IanL7/connect453/hardware/microcontroller_board/3D/APA102C.STEP

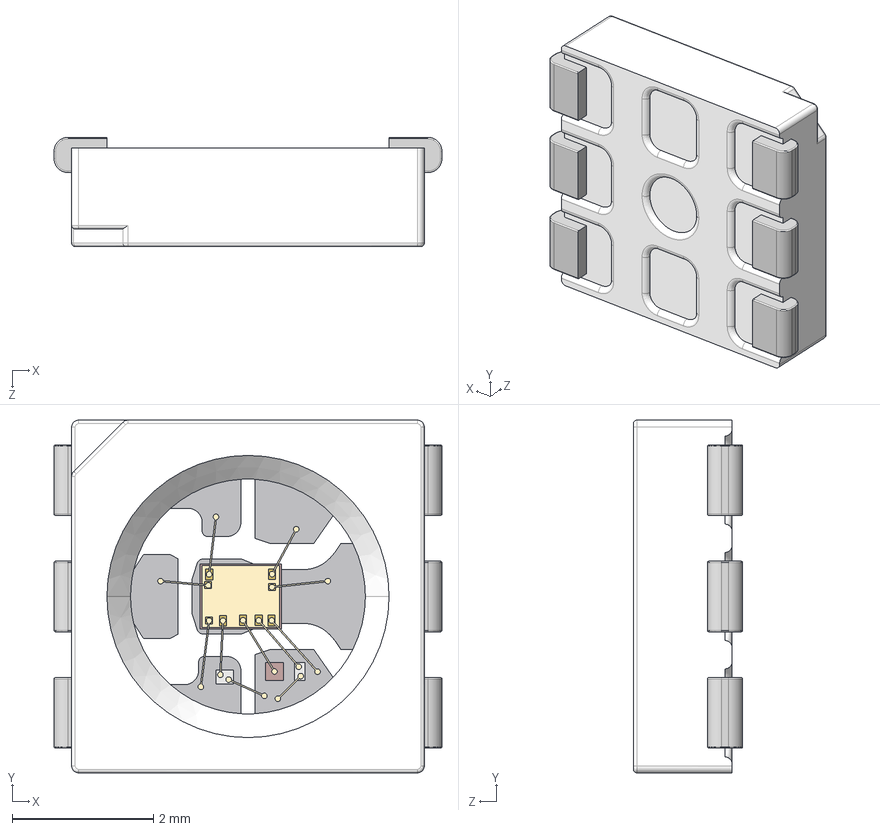
[picture p2: CAD file, 2024-05-06]
hardware/microcontroller_board/3D/APA102C.STEP
5.50 x 5.00 x 1.55 mm
