IanL7/connect453/hardware/microcontroller_board/Parts/TPA6211TDGNRQ1/VSSOP_DGNRQ1_TEX.step

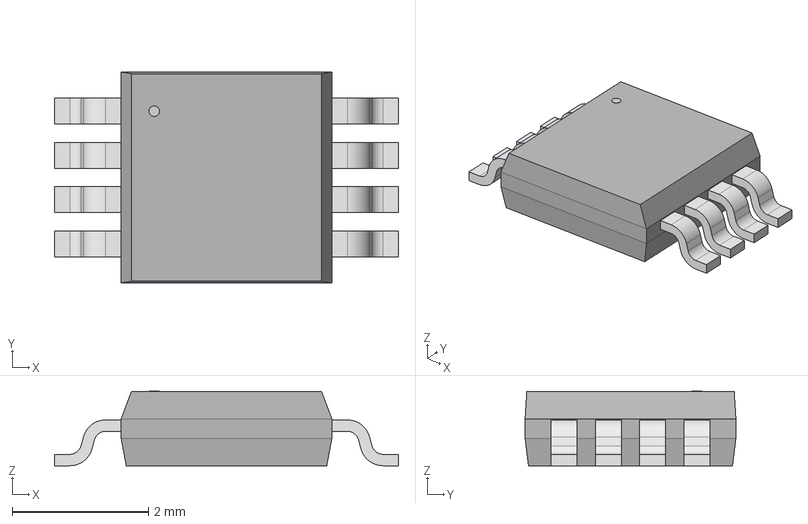
[picture p3: CAD file, 2024-05-06]
hardware/microcontroller_board/Parts/TPA6211TDGNRQ1/VSSOP_DGNRQ1_TEX.step
5.05 x 3.10 x 1.09 mm
