IanL7/connect453/hardware/microcontroller_board/3D/STEP-61301021821-rev1.stp

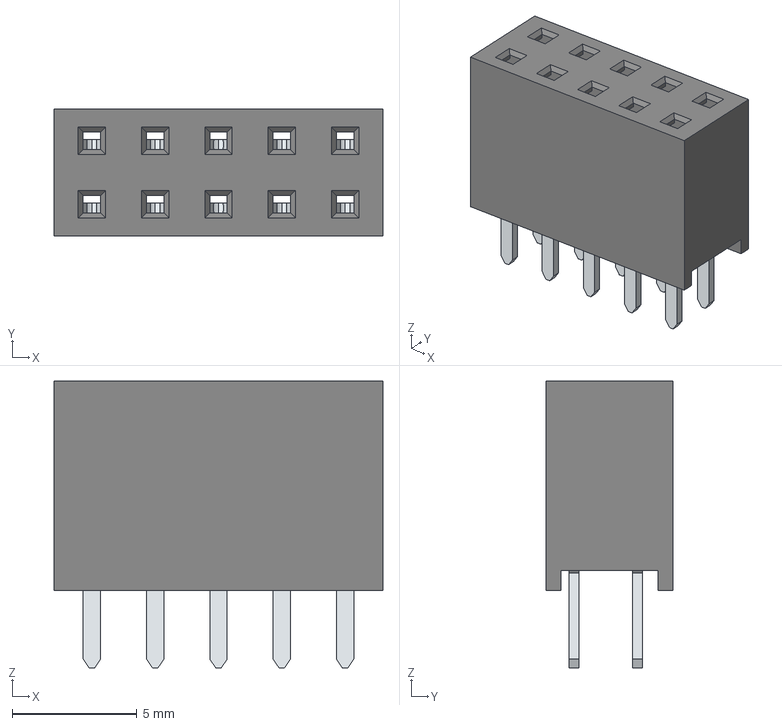
[picture p4: CAD file, 2024-05-06]
hardware/microcontroller_board/3D/STEP-61301021821-rev1.stp
13.2 x 5.08 x 11.5 mm
6130xx21821_PIN x 10
