IanL7/connect453/hardware/microcontroller_board/3D/BU2032SM-HD-GCR2032 Battery Holder.stp

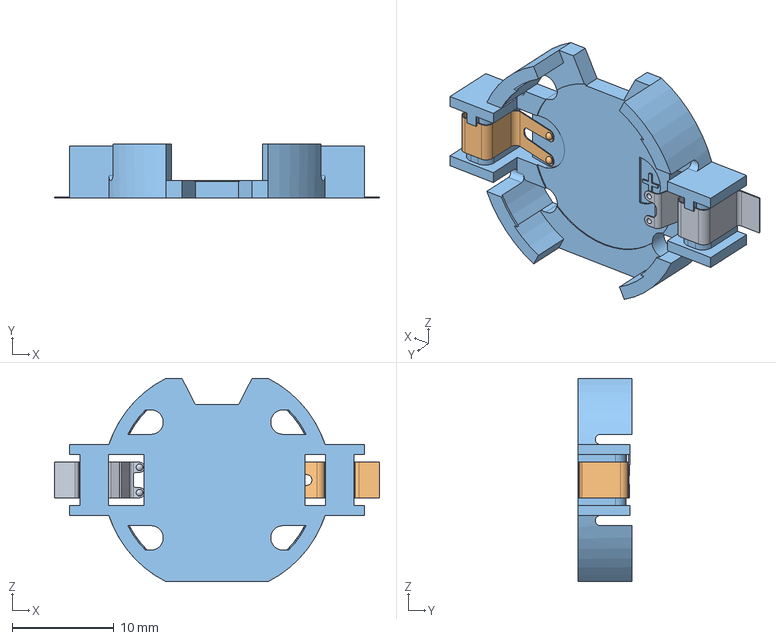
[picture p5: CAD file, 2024-05-06]
hardware/microcontroller_board/3D/BU2032SM-HD-GCR2032 Battery Holder.stp
32.0 x 5.30 x 20.0 mm
