IanL7/connect453/hardware/microcontroller_board/ECE453-MCU.pdf

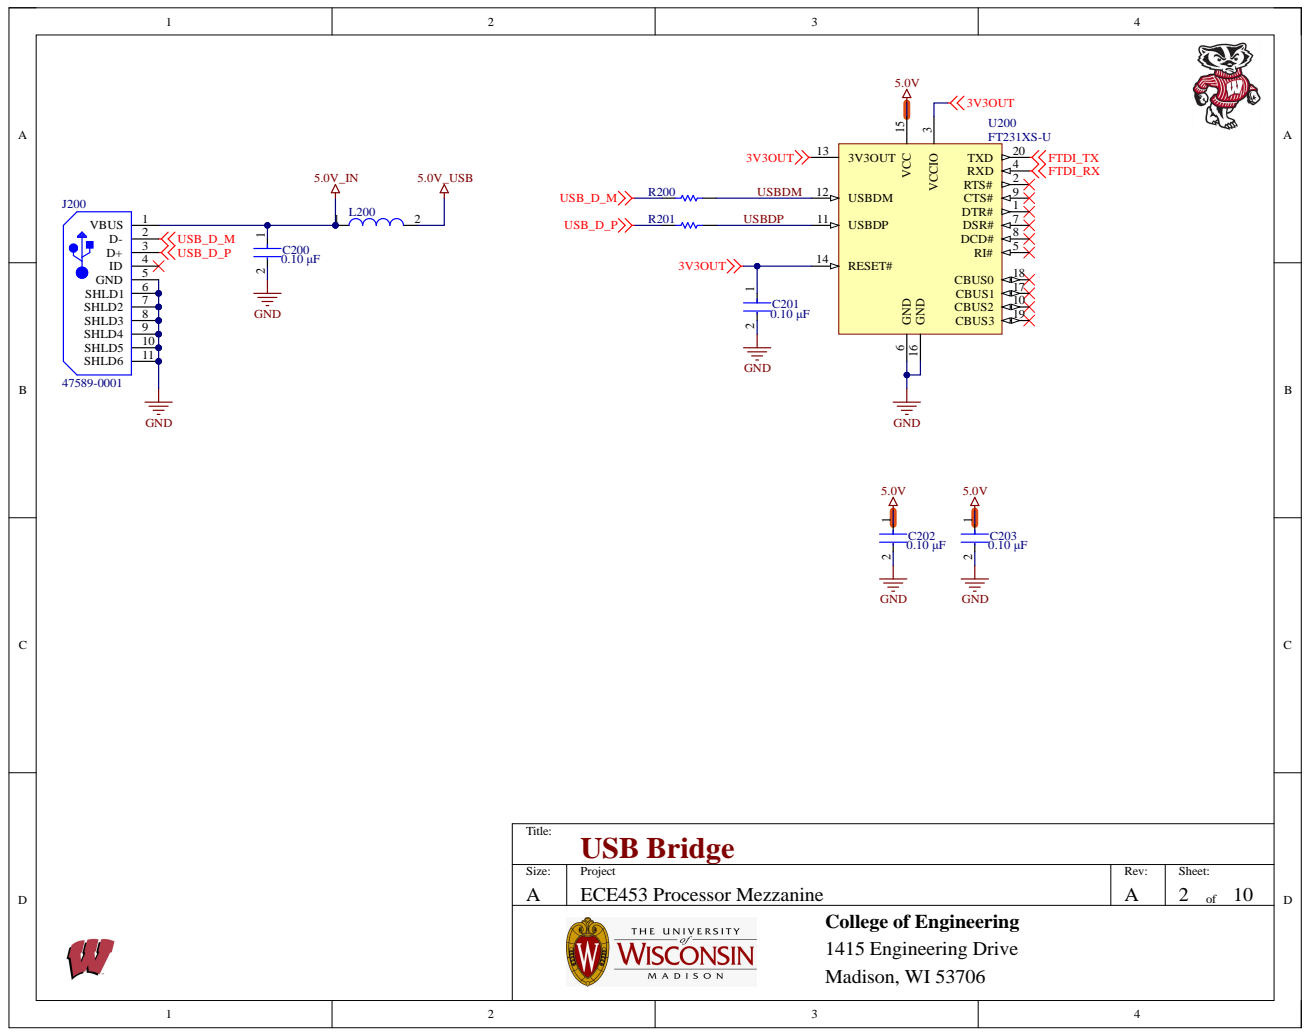
[picture p6: page 1]

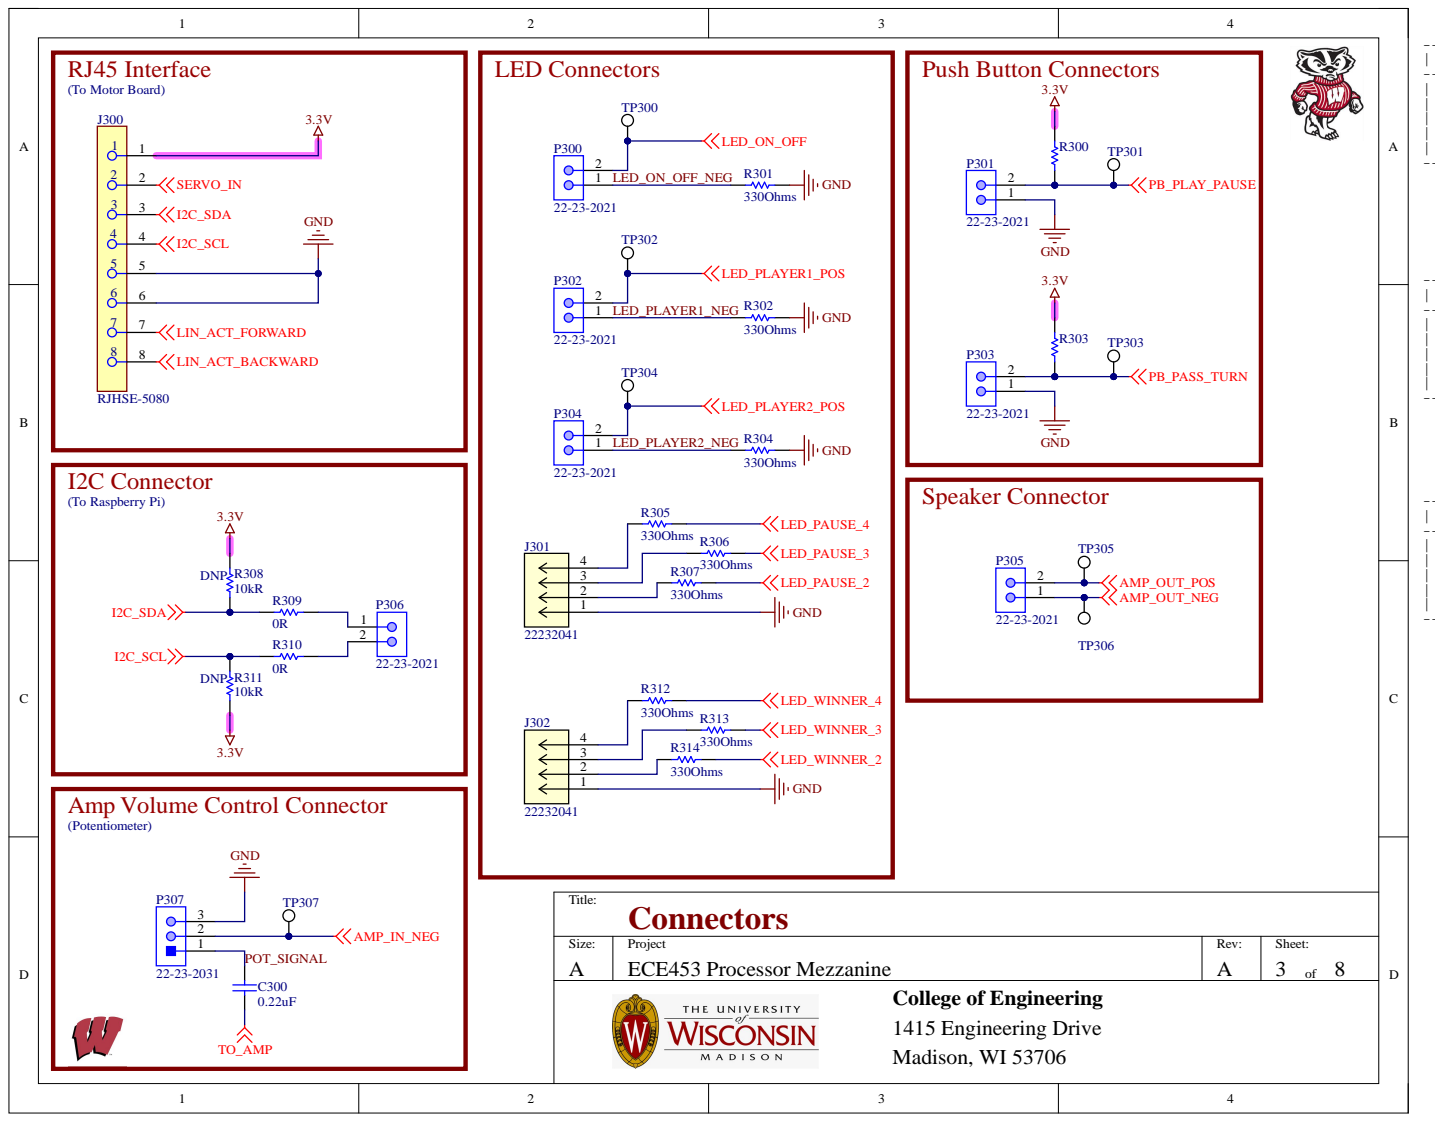
[picture p7: page 2]

Amp Volume Control Connector

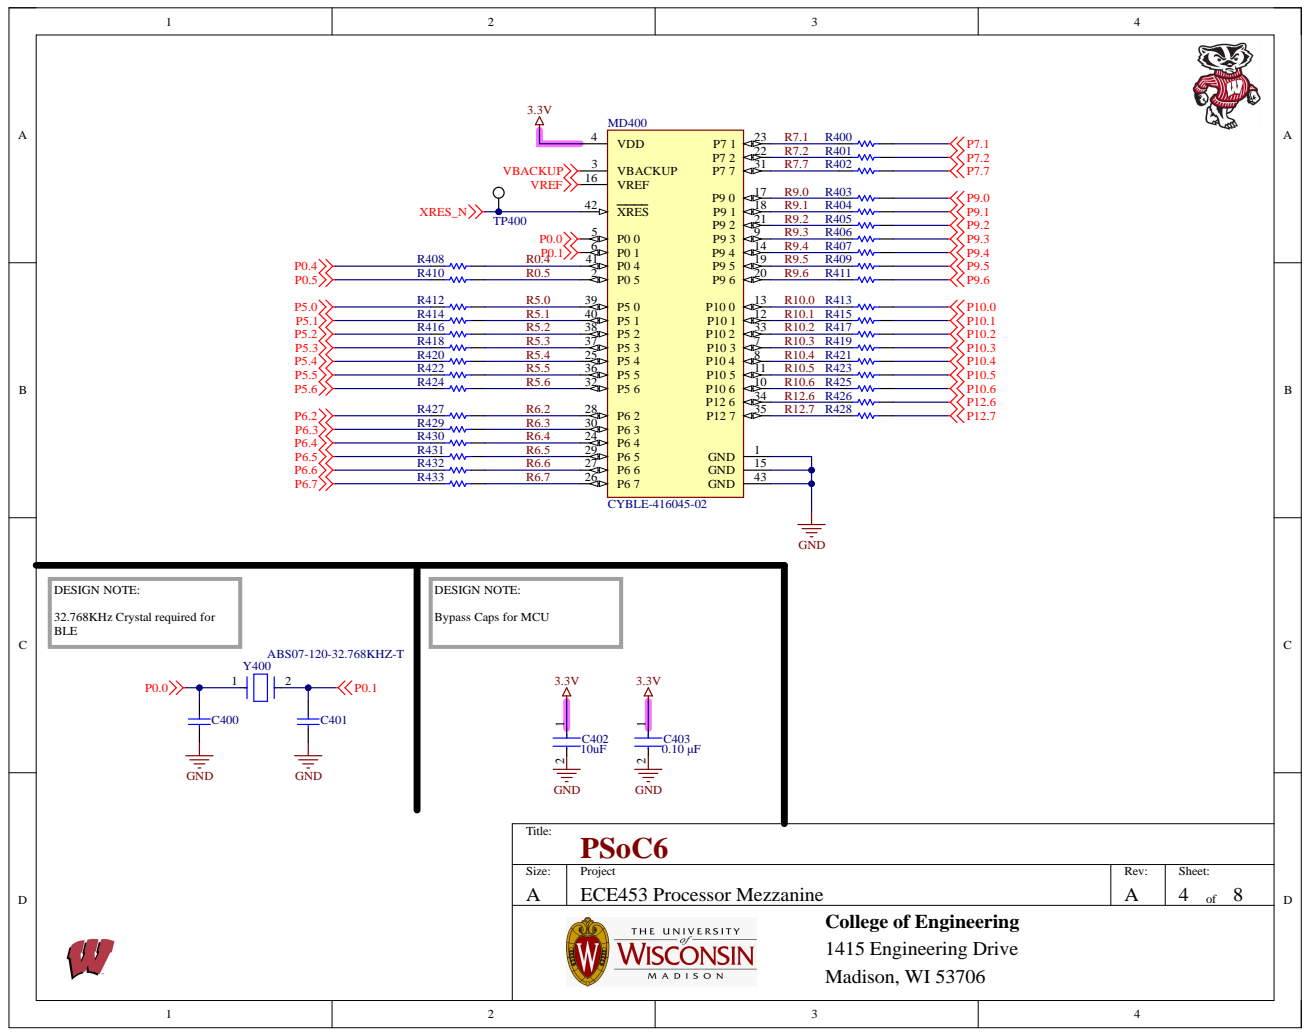
[picture p8: page 3]

Bypass Caps for MCU

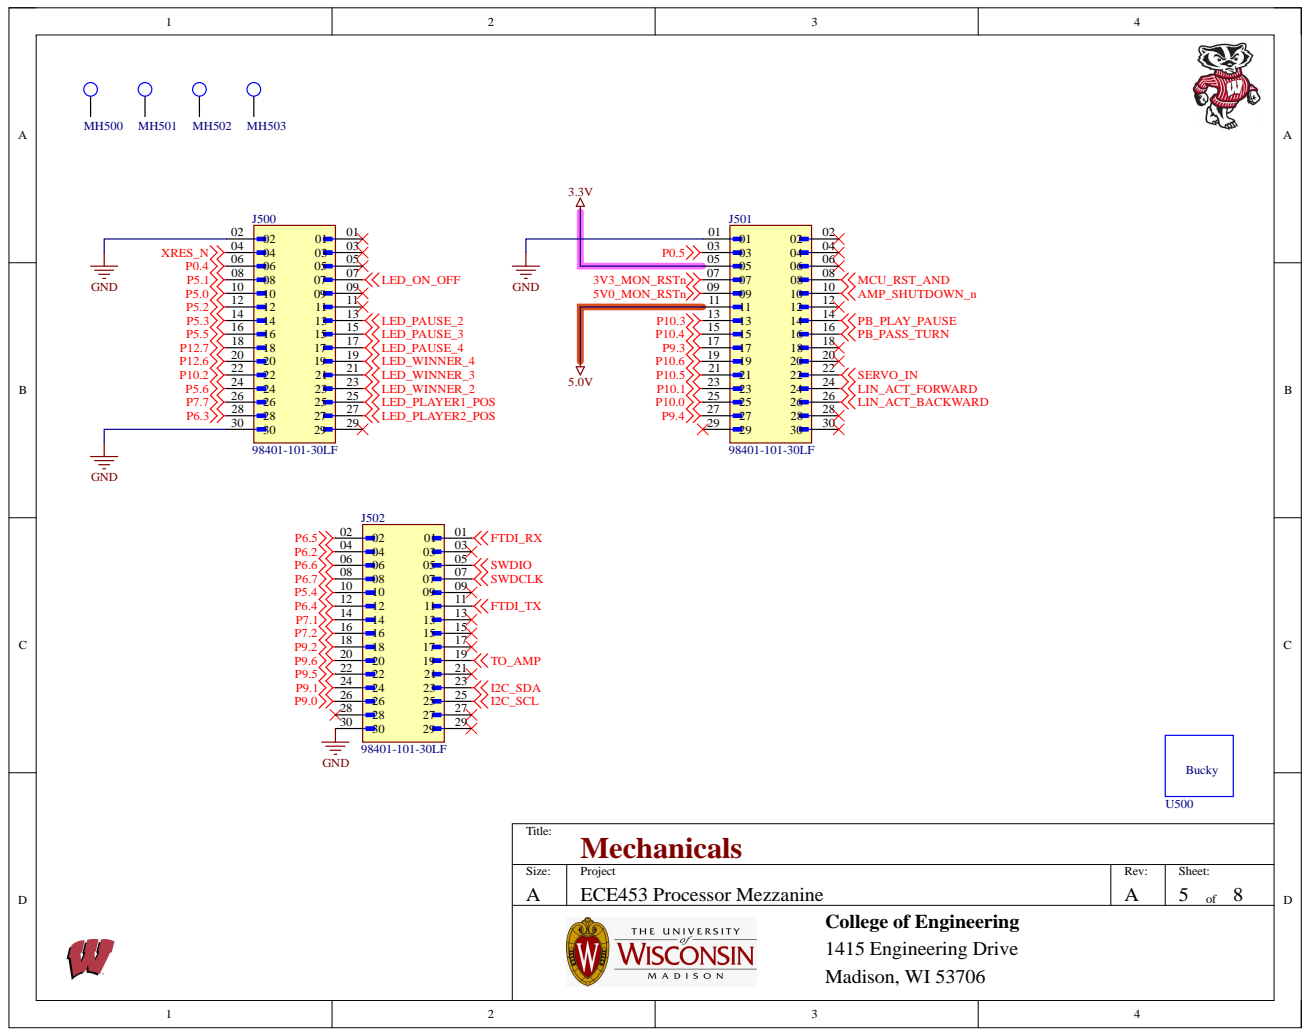
[picture p9: page 4]

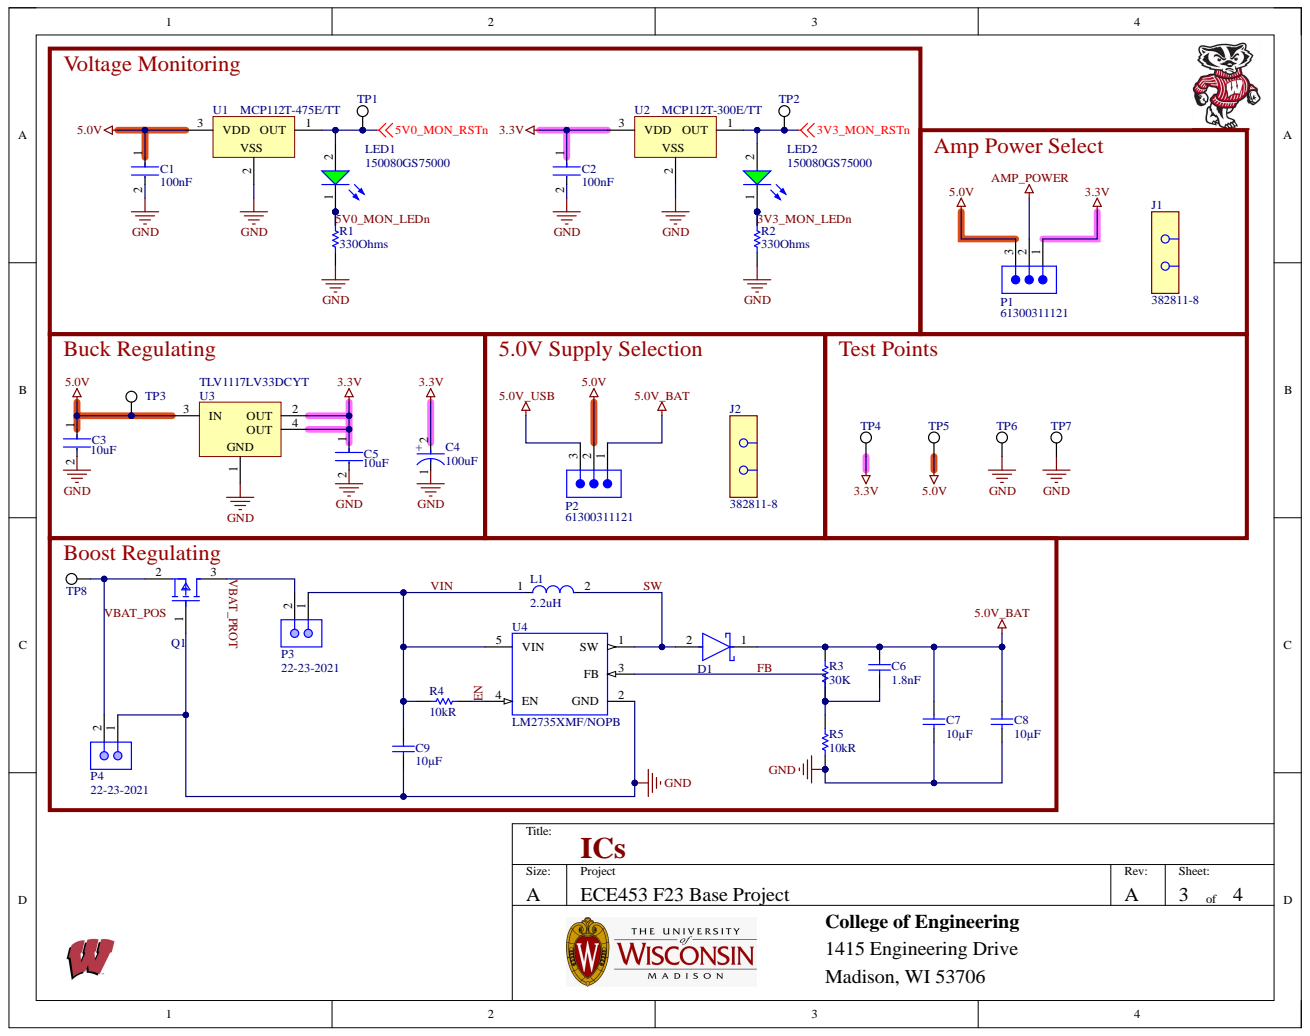
[picture p10: page 5]

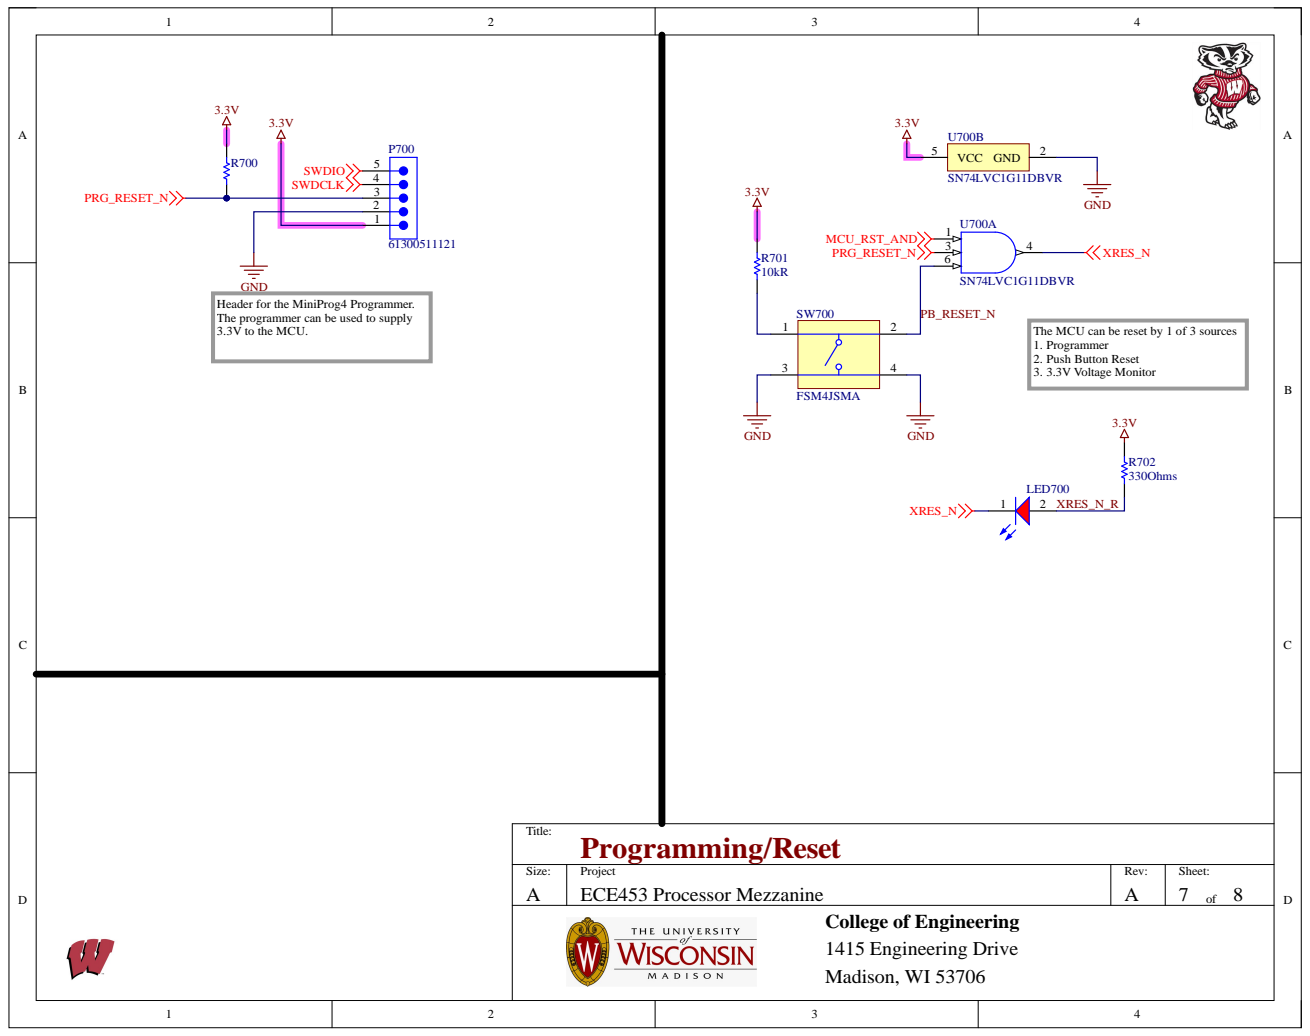
[picture p11: page 6]

GND
Header for the MiniProg4 Programmer.
The programmer can be used to supply

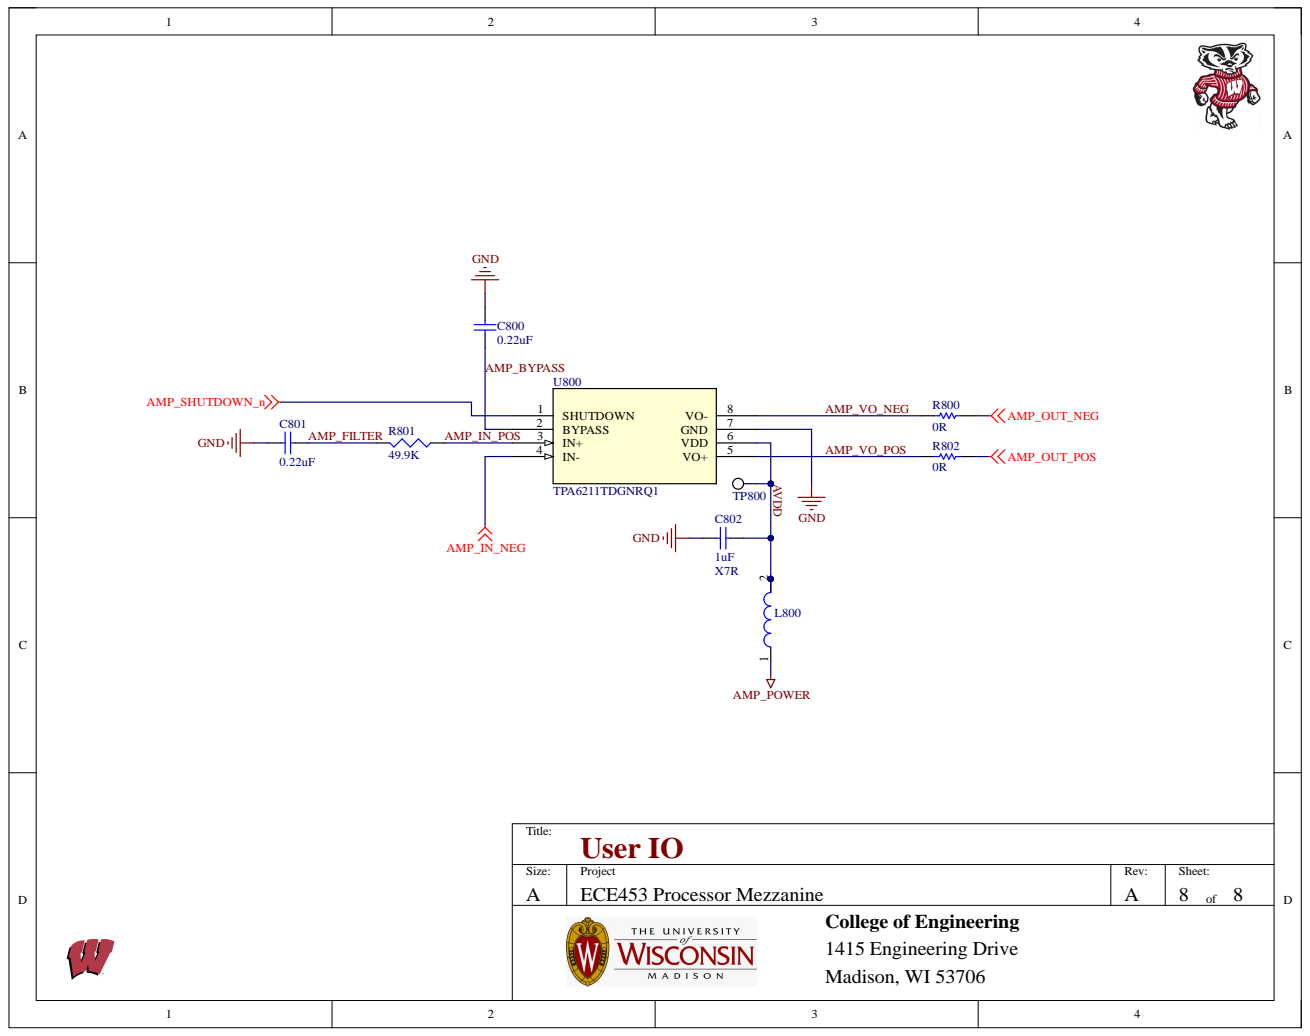
[picture p12: page 7]
