IanL7/connect453/(list of files, drawings)

Other design files:
hardware/microcontroller_board/01-Revision_History_and_Contents.SchDoc
hardware/microcontroller_board/02_USB_Bridge.SchDoc
hardware/microcontroller_board/03_Connectors.SchDoc
hardware/microcontroller_board/04-MCU.SchDoc
hardware/microcontroller_board/05_Mechanicals.SchDoc
hardware/microcontroller_board/06_Power.SchDoc
hardware/microcontroller_board/07_Programming_Reset.SchDoc
hardware/microcontroller_board/08_Amp.SchDoc
hardware/microcontroller_board/ECE453-MCU.PrjPcb
hardware/microcontroller_board/ECE453.SCHLIB
hardware/microcontroller_board/Parts/Molex4Male/22232041.PcbLib
hardware/microcontroller_board/Parts/Molex4Male/22232041.SchLib
hardware/microcontroller_board/Parts/TB006_508_02BE/TB006_-508-02BE/CUI_TB006 -508-02BE.PcbLib
hardware/microcontroller_board/Parts/TB006_508_02BE/TB006_-508-02BE/TB006_-508-02BE.SchLib
hardware/microcontroller_board/Parts/TB006_508_03BE/TB006-508-03BE/CUI_TB006-508-03BE.PcbLib
hardware/microcontroller_board/Parts/TB006_508_03BE/TB006-508-03BE/TB006-508-03BE.SchLib
hardware/microcontroller_board/Parts/TPA6211TDGNRQ1/TPA6211TDGNRQ1.PcbLib
hardware/microcontroller_board/Parts/TPA6211TDGNRQ1/TPA6211TDGNRQ1.SchLib
hardware/motor_driver_board/01-Revision_History_and_Contents.SchDoc
hardware/motor_driver_board/02_Connectors.SchDoc
hardware/motor_driver_board/03_ICs.SchDoc
hardware/motor_driver_board/04_Mechanical.SchDoc
hardware/motor_driver_board/ECE453-Motor-Base.PrjPcb
hardware/motor_driver_board/ECE453.PcbDoc
hardware/motor_driver_board/ECE453.SCHLIB
hardware/motor_driver_board/Parts/SR733ATTER165F/SR733ATTER165F/RESC6432X70N.PcbLib
hardware/motor_driver_board/Parts/SR733ATTER165F/SR733ATTER165F/SR733ATTER165F.SchLib
hardware/relay_board/01-Revision_History_and_Contents.SchDoc
hardware/relay_board/02_Connectors.SchDoc
hardware/relay_board/03_ICs.SchDoc
hardware/relay_board/04_Mechanical.SchDoc
hardware/relay_board/ECE453-RelayBoard.PrjPcb
hardware/relay_board/ECE453.PcbDoc
hardware/relay_board/ECE453.SCHLIB
hardware/relay_board/parts/J1021CS312VDC_20/AltiumDesigner/J1021CS312VDCP20.PcbLib
hardware/relay_board/parts/J1021CS312VDC_20/AltiumDesigner/J1021CS312VDCP20.SchLib
