IanL7/connect453/(commit log)

2023-11-08 work on state machine, draft of i2c
2023-11-08 fill in winning checks for board processor
2023-12-01 fix pb roll over
    [main.c]
2023-12-05 light sensor working
2023-12-06 remove debug printf
2023-12-06 work on servo
2023-12-06 add motor code
2023-12-06 motor stuff
2024-05-06 add some hardware files and update readme
    [01-Revision_History_and_Contents.SchDoc, 02_Connectors.SchDoc, 02_USB_Bridge.SchDoc, 03_Connectors.SchDoc, 03_ICs.SchDoc, 04-MCU.SchDoc, 04_Mechanical.SchDoc, 05_Mechanicals.SchDoc]
2024-05-13 add motor driver files and update readme
    [01-Revision_History_and_Contents.SchDoc, 02_Connectors.SchDoc, 03_ICs.SchDoc, 04_Mechanical.SchDoc, ECE453-Motor-Base.PrjPcb, ECE453.PcbDoc, ECE453.SCHLIB, RESC6432X70N.PcbLib]
2024-05-13 hardware -> PCB
